IeiuniumLux/FRILLER/stl/Main_Center_Body_Piece.STL

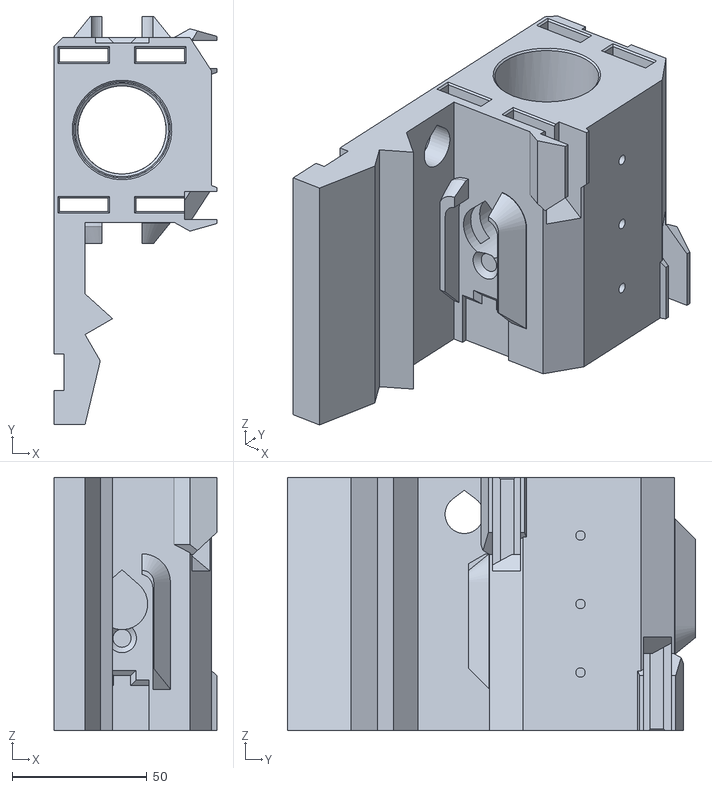
[picture p3: CAD file, 2018-04-26]
stl/Main_Center_Body_Piece.STL
60.3 x 151.4 x 94.0
