IeiuniumLux/FRILLER/stl/Wheel_Center.STL

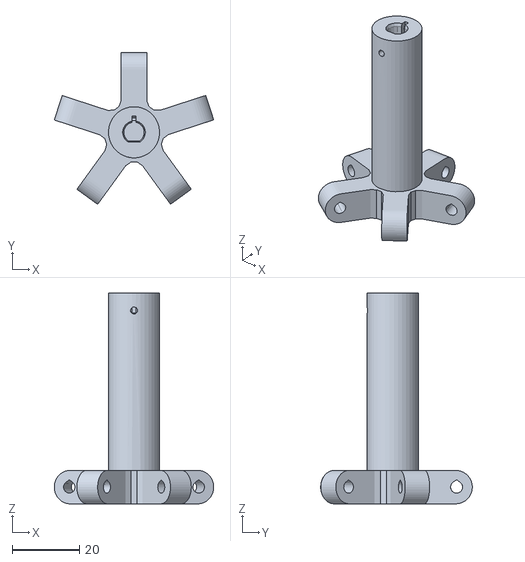
[picture p4: CAD file, 2018-09-07]
stl/Wheel_Center.STL
47.5 x 45.2 x 62.9
