IeiuniumLux/FRILLER/stl/Actuation_Part_A.STL

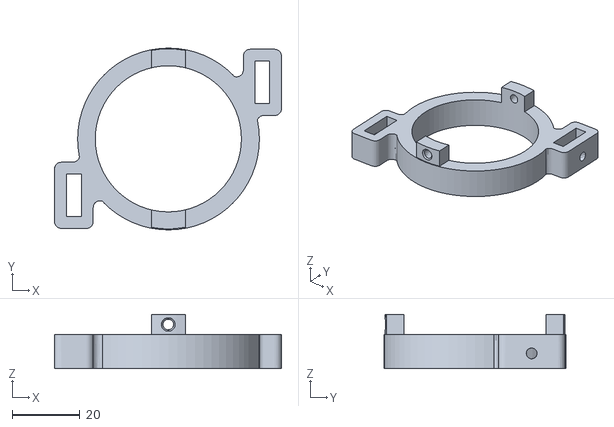
[picture p5: CAD file, 2018-09-07]
stl/Actuation_Part_A.STL
66.8 x 53.5 x 16.0
