IeiuniumLux/FRILLER/stl/Tail.stl

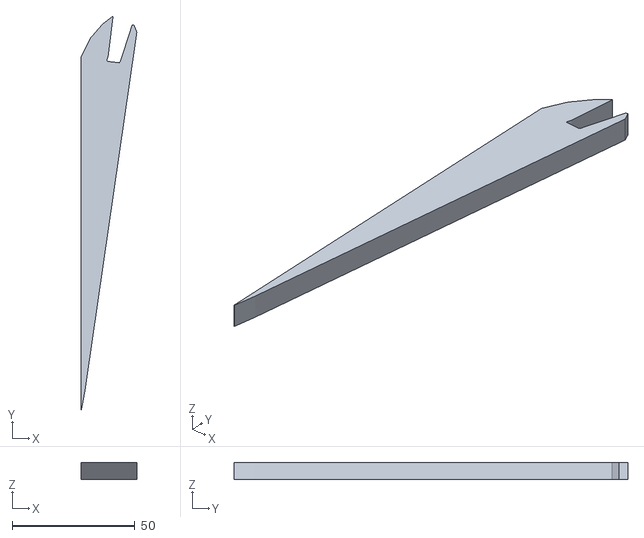
[picture p6: CAD file, 2018-04-29]
stl/Tail.stl
22.7 x 160.3 x 7.00
