IeiuniumLux/FRILLER/stl/Wheel_Petal_Elastic_Tie_Down.STL

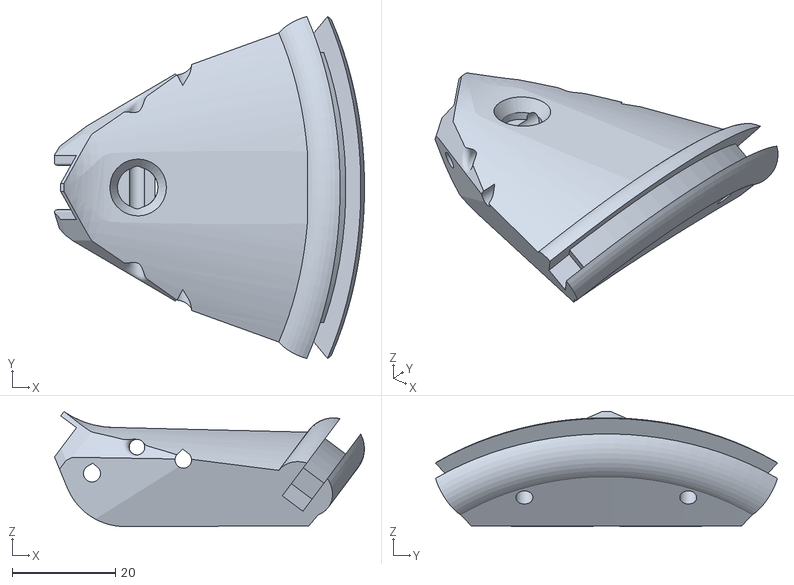
[picture p7: CAD file, 2018-04-26]
stl/Wheel_Petal_Elastic_Tie_Down.STL
60.1 x 66.3 x 22.3
