IeiuniumLux/FRILLER/stl/Actuation_Part_C.STL

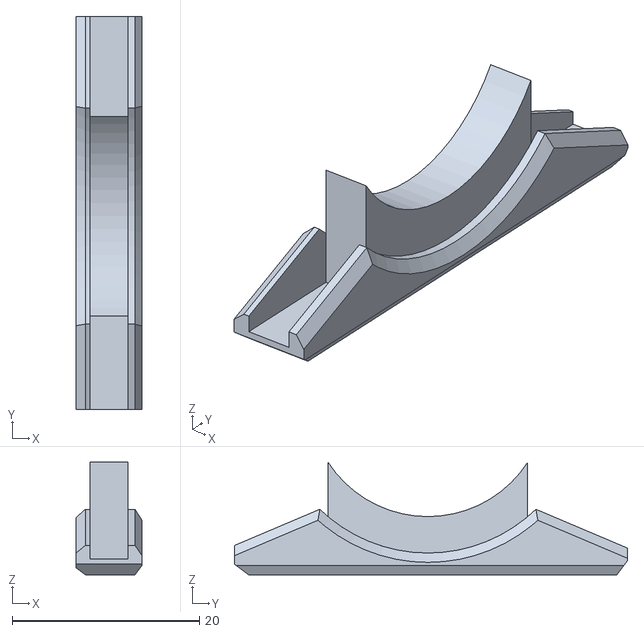
[picture p8: CAD file, 2018-04-26]
stl/Actuation_Part_C.STL
7.06 x 42.0 x 12.0
