IeiuniumLux/FRILLER/stl/Spacer_Peg.STL

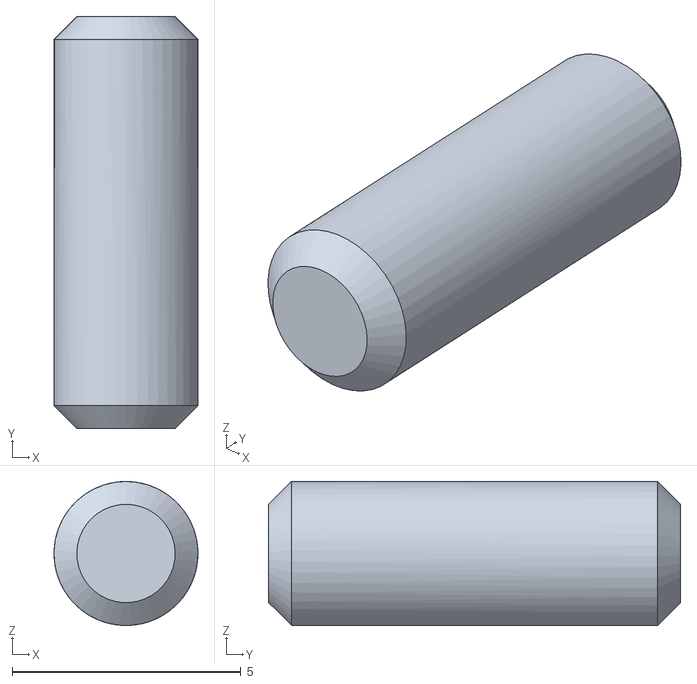
[picture p9: CAD file, 2018-04-26]
stl/Spacer_Peg.STL
3.15 x 9.01 x 3.15
