IeiuniumLux/FRILLER/stl/Actuation_Beam.STL

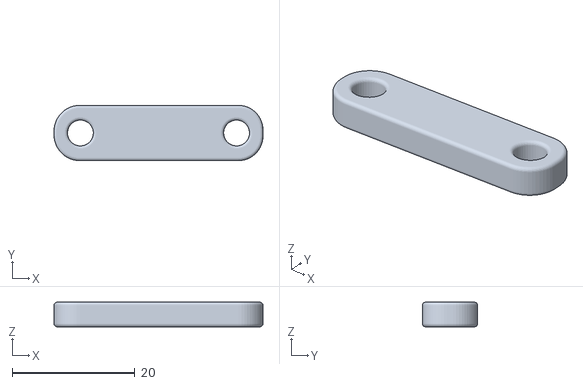
[picture p10: CAD file, 2018-04-26]
stl/Actuation_Beam.STL
34.0 x 9.00 x 4.00
