IeiuniumLux/FRILLER/stl/Offroad_Grip_1_Left.STL

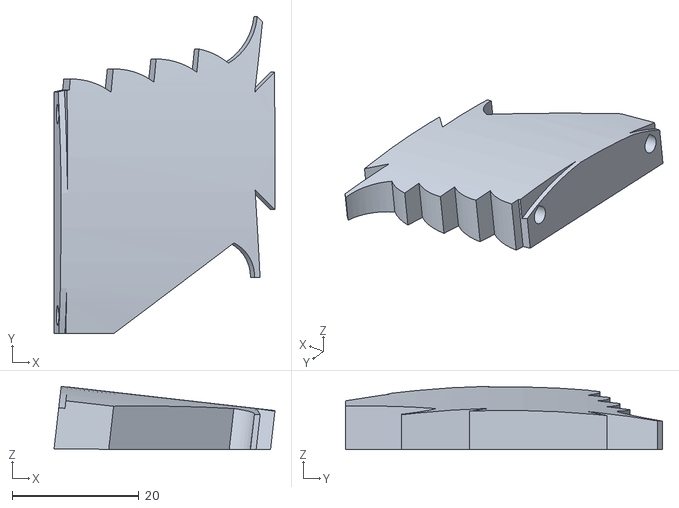
[picture p11: CAD file, 2018-04-26]
stl/Offroad_Grip_1_Left.STL
34.8 x 50.0 x 9.97
