IeiuniumLux/FRILLER/stl/Pinion_Small_Version_For_Printing.STL

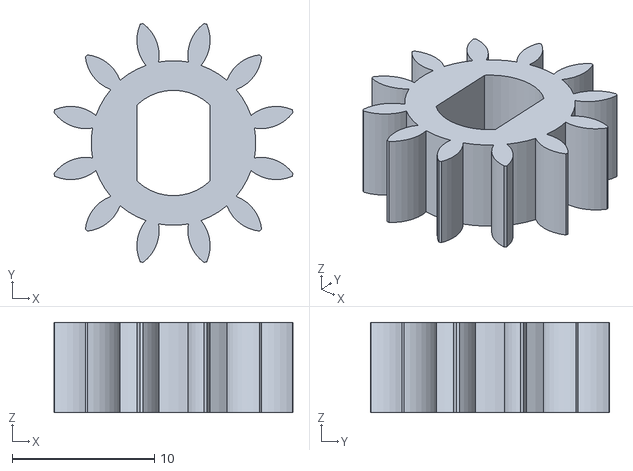
[picture p12: CAD file, 2018-04-26]
stl/Pinion_Small_Version_For_Printing.STL
16.8 x 16.8 x 6.35
