IeiuniumLux/FRILLER/stl/TW_MOLD.SLDPRT

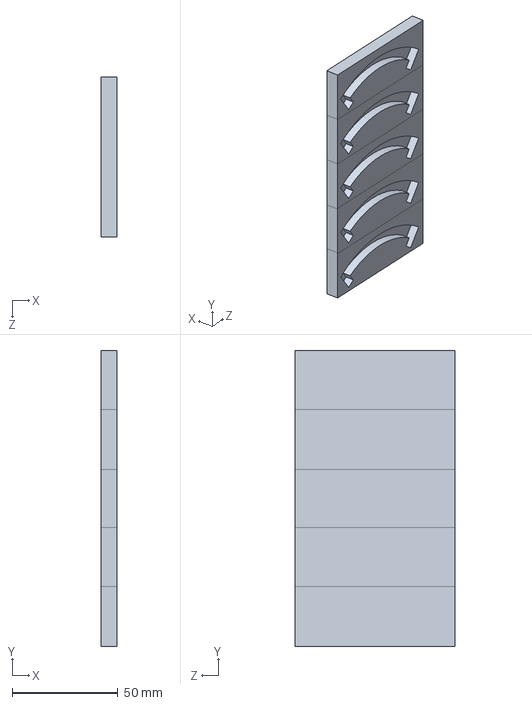
[picture p13: CAD file, 2018-04-26]
stl/TW_MOLD.SLDPRT
7.50 x 140.2 x 75.6 mm
