IeiuniumLux/FRILLER/stl/Rack.STL

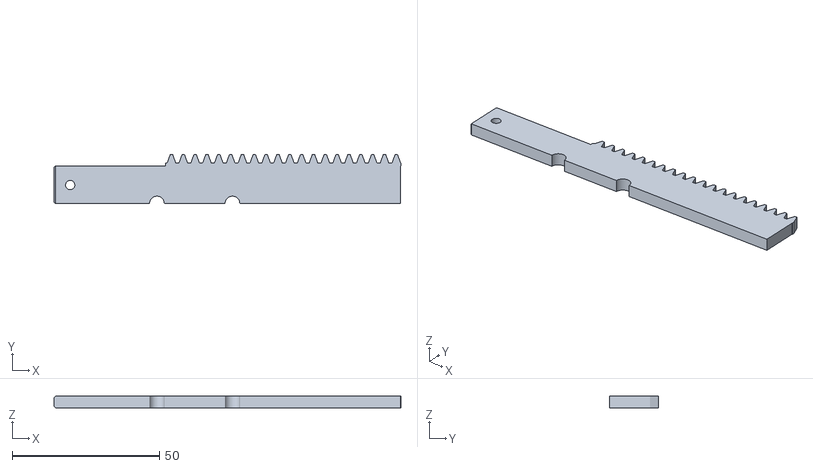
[picture p14: CAD file, 2018-04-26]
stl/Rack.STL
117.9 x 16.6 x 4.00
