IeiuniumLux/FRILLER/stl/Actuation_Part_B.STL

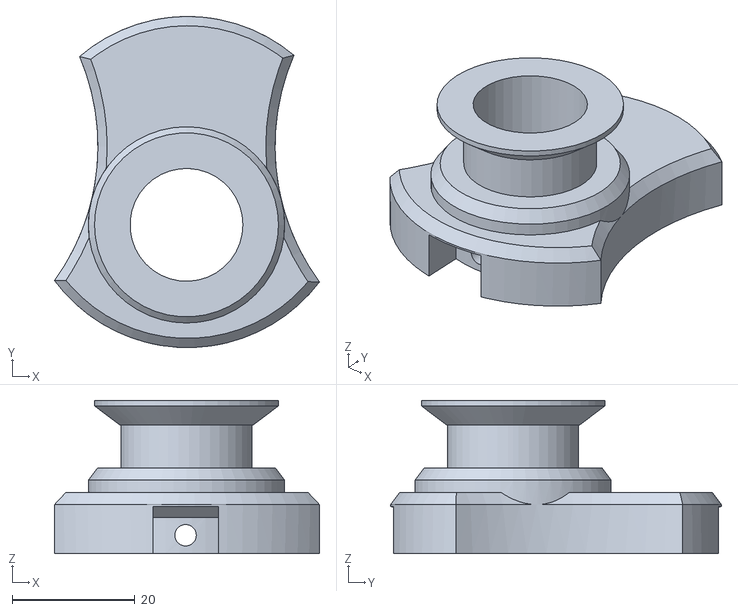
[picture p15: CAD file, 2018-04-26]
stl/Actuation_Part_B.STL
43.2 x 54.0 x 25.0
