IeiuniumLux/FRILLER/stl/Rear_Passive_Wheel.STL

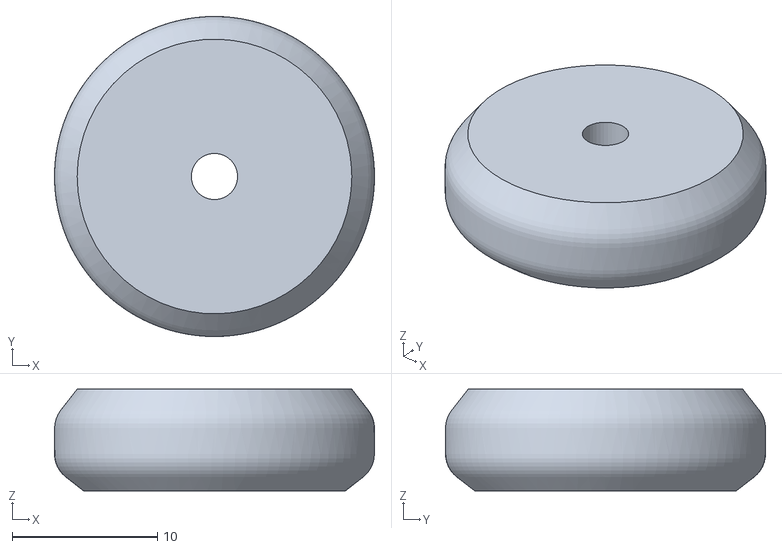
[picture p16: CAD file, 2018-04-26]
stl/Rear_Passive_Wheel.STL
22.0 x 22.0 x 7.00
