IeiuniumLux/FRILLER/stl/Actuation_Part_D.STL

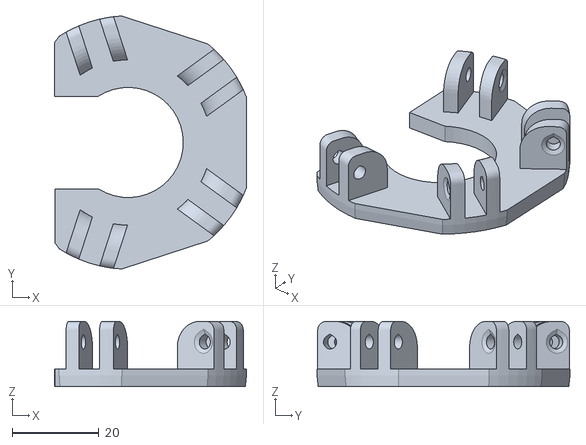
[picture p17: CAD file, 2018-04-26]
stl/Actuation_Part_D.STL
44.3 x 58.3 x 15.0
