IeiuniumLux/FRILLER/stl/Tail_Part_of_Body.STL

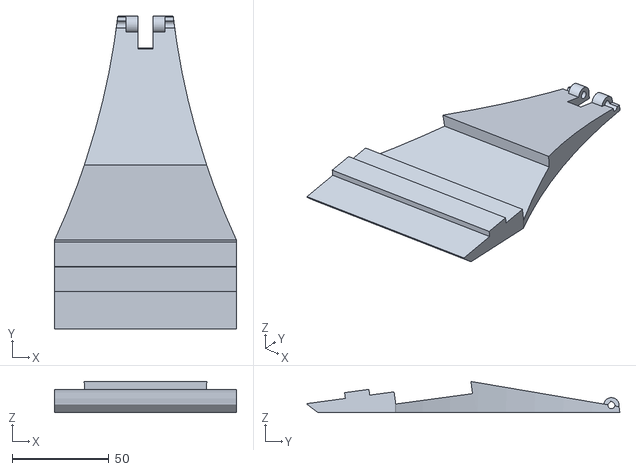
[picture p18: CAD file, 2018-04-26]
stl/Tail_Part_of_Body.STL
94.0 x 161.5 x 16.1
