IeiuniumLux/FRILLER/stl/Wheel_Petal_Passive.STL

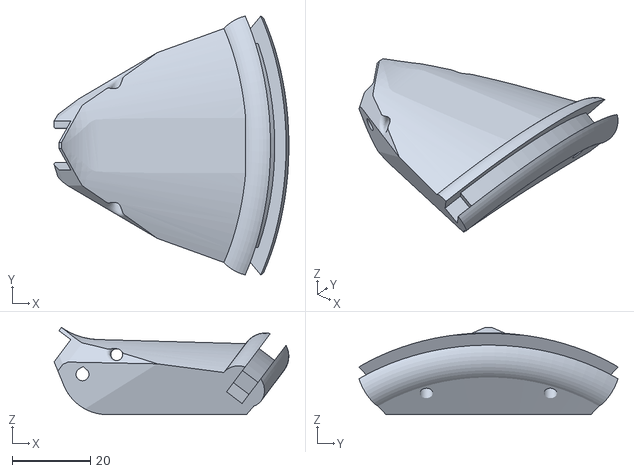
[picture p19: CAD file, 2018-04-26]
stl/Wheel_Petal_Passive.STL
60.1 x 66.3 x 22.4
