IeiuniumLux/FRILLER/(list of files, cad)

Other CAD files:
stl/Wheel_Petal_Standard.STL
stl/Offroad_Grip_1_Right.STL
stl/TW_MOLD.stl
