IeiuniumLux/FRILLER/(commit log)

2018-04-26 intial commit
    [Actuation_Beam.STL, Actuation_Part_A.STL, Actuation_Part_B.STL, Actuation_Part_C.STL, Actuation_Part_D.STL, Main_Center_Body_Piece.STL, Offroad_Grip_1_Left.STL, Offroad_Grip_1_Right.STL]
2018-10-05 Update README.md
    I translate FRILLER's introduction from Raspberry Pi official magazine the MagPi into simplified Chinese, for Chinese makers to learn more about this phenomenal robots and try to make it better.
